LoZioo/Nucleo-Recorder/README.md

# Nucleo-Recorder
Legacy Nucleo-Recorder project repository.

[Brief documentation](docs/step%202.pdf)

## Final result
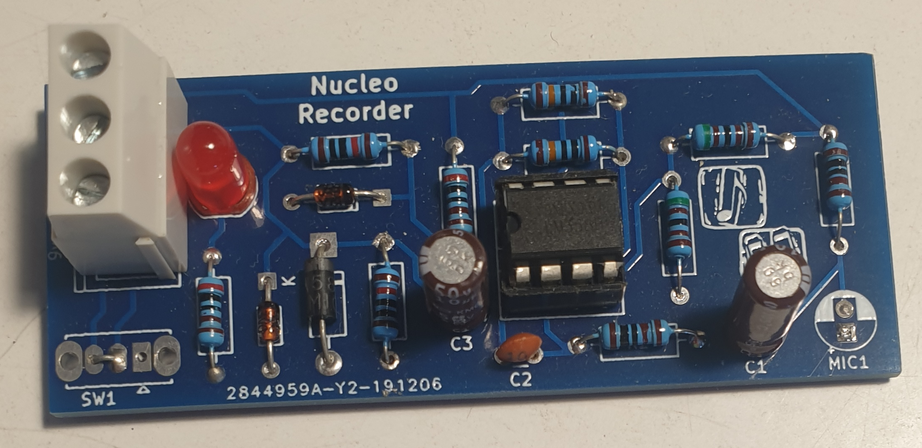
[picture p1: schematics/Device.png]
Device
