LoZioo/Nucleo-Recorder/docs/step 2/ADC_IRQ.JPG

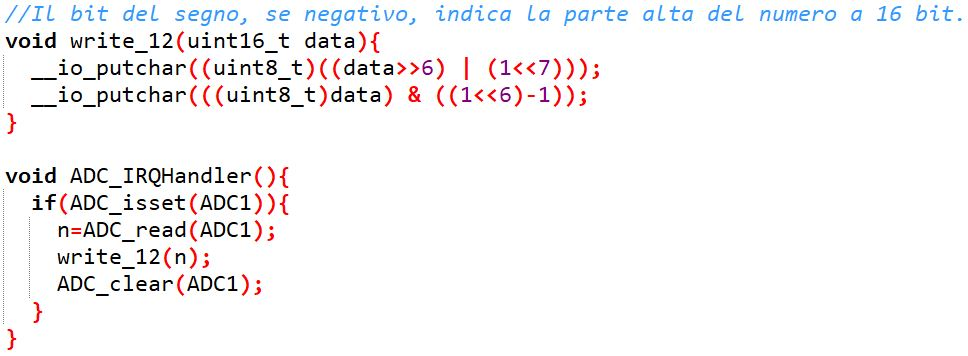
docs/step 2/ADC_IRQ.JPG
