LoZioo/Nucleo-Recorder/docs/step 2/Circuito.JPG

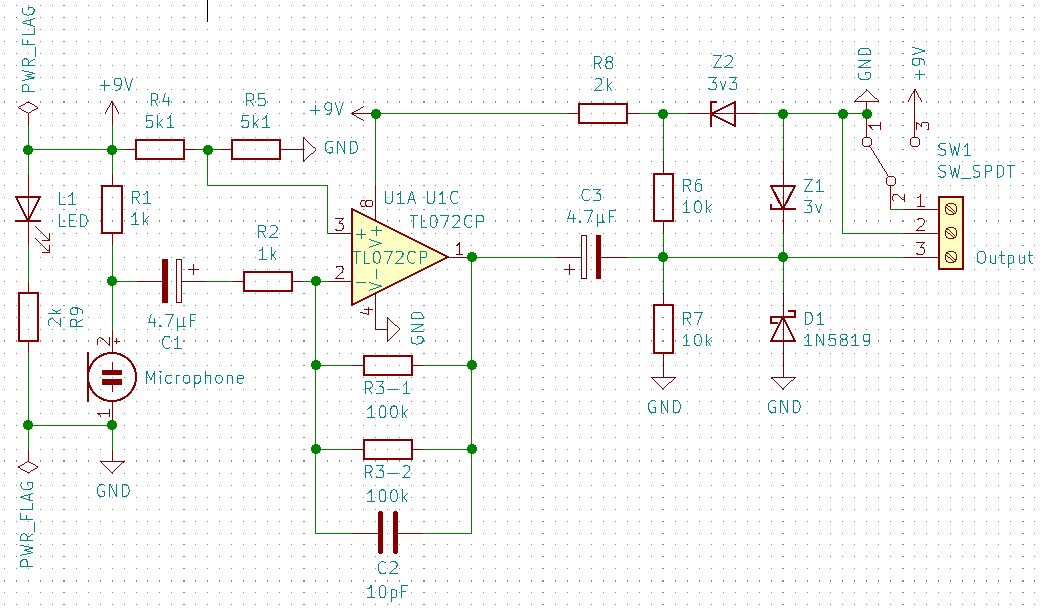
docs/step 2/Circuito.JPG
