LoZioo/Nucleo-Recorder/docs/step 2/Timer.JPG

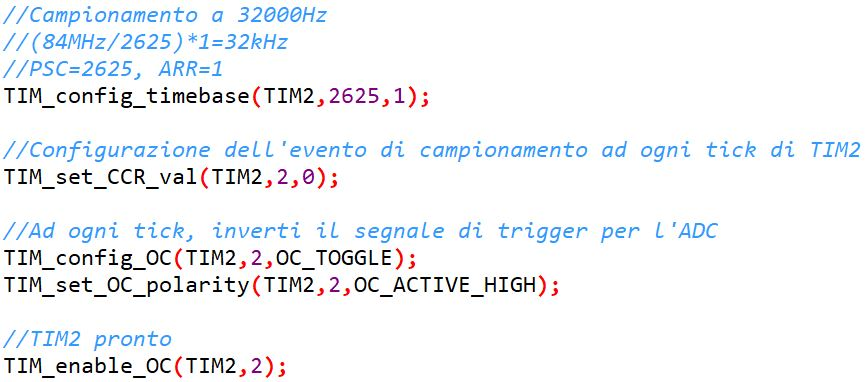
docs/step 2/Timer.JPG
