LoZioo/Nucleo-Recorder/docs/step 3/bit.jpg

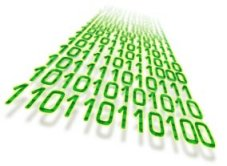
docs/step 3/bit.jpg
