LoZioo/Nucleo-Recorder/docs/step 3/electret-microphone.jpg

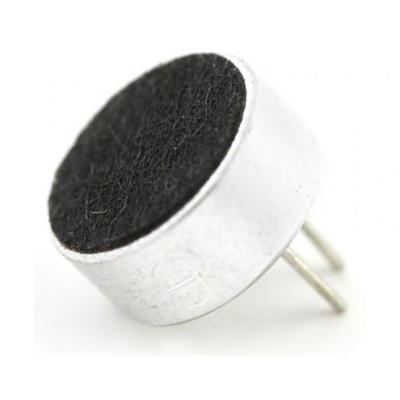
docs/step 3/electret-microphone.jpg
