LoZioo/Nucleo-Recorder/docs/step 3/FM Transmitter.JPG

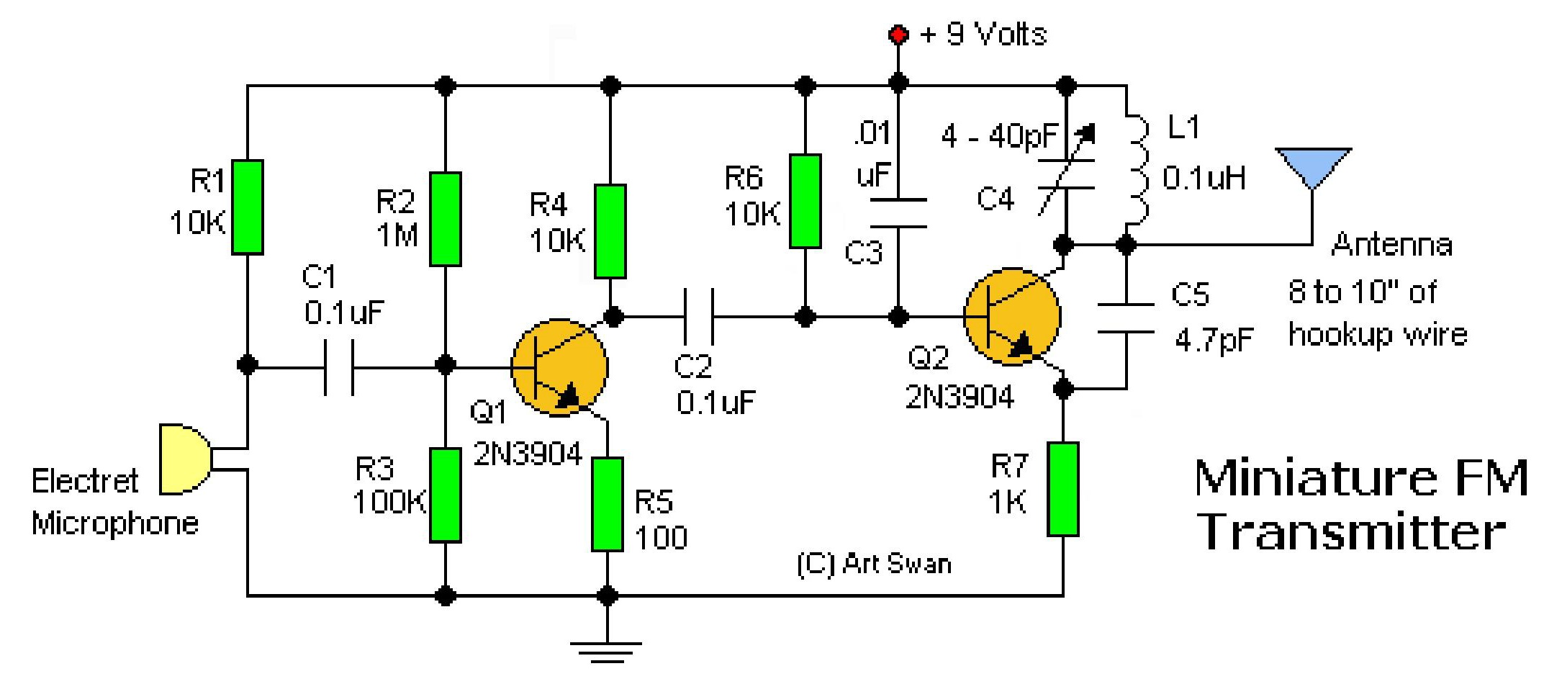
docs/step 3/FM Transmitter.JPG
