LoZioo/Nucleo-Recorder/docs/step 3/FM-Transmitter-Circuit.jpg

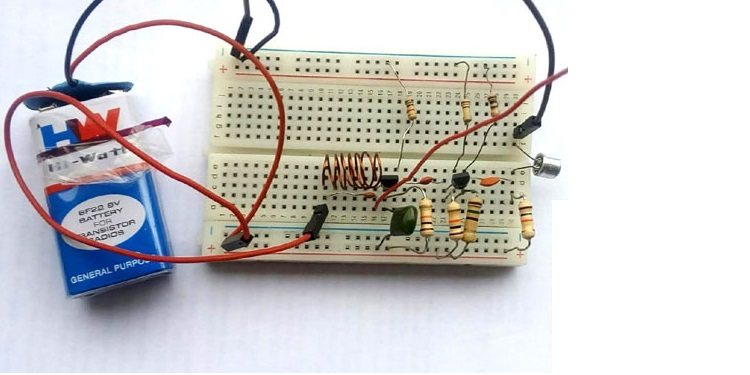
docs/step 3/FM-Transmitter-Circuit.jpg
