LoZioo/Nucleo-Recorder/docs/step 3/idea.jpg

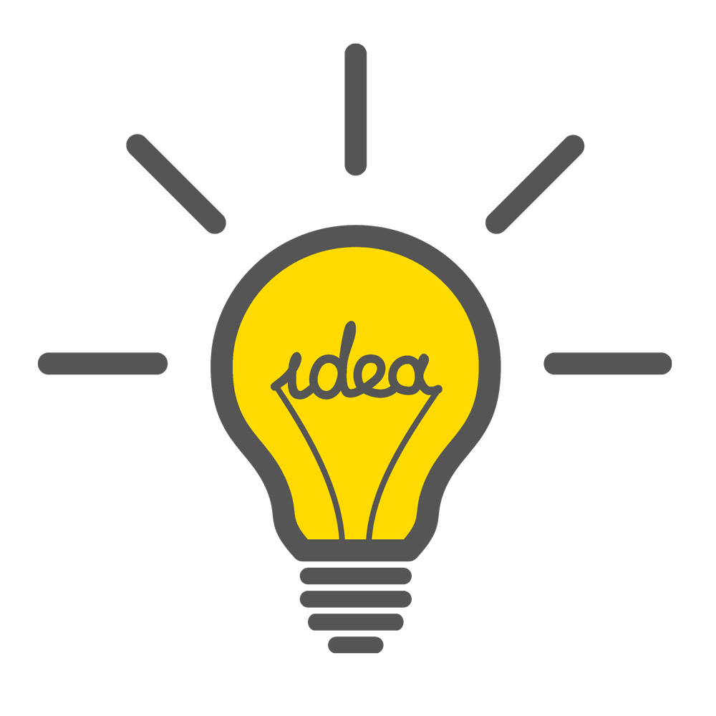
docs/step 3/idea.jpg
