LoZioo/Nucleo-Recorder/docs/step 3/not bad.jpg

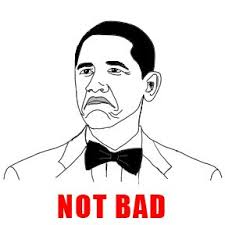
docs/step 3/not bad.jpg
