LoZioo/Nucleo-Recorder/docs/step 3/PCB.JPG

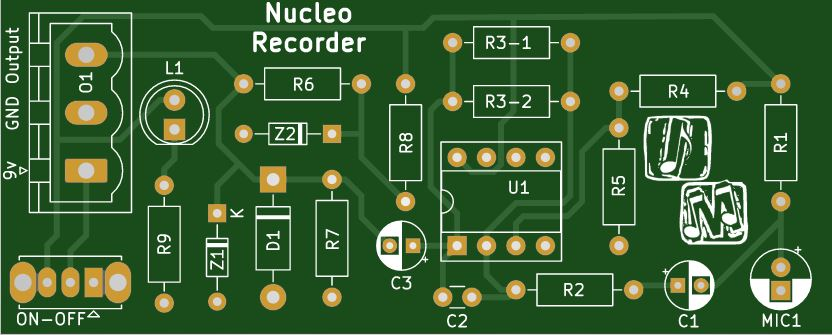
docs/step 3/PCB.JPG
