LoZioo/Nucleo-Recorder/docs/step 3/stm32-nucleo-f401re.jpg

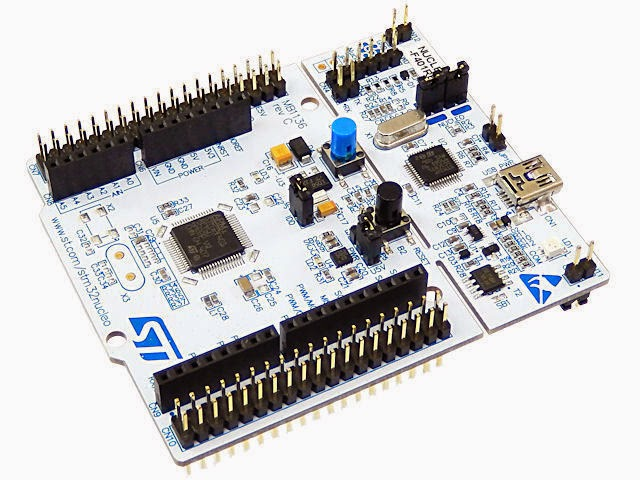
docs/step 3/stm32-nucleo-f401re.jpg
