LoZioo/Nucleo-Recorder/schematics/Microfono/Microfono.kicad_pcb

## KiCad design schematics/Microfono/Microfono.kicad_pcb (2023-10-05)

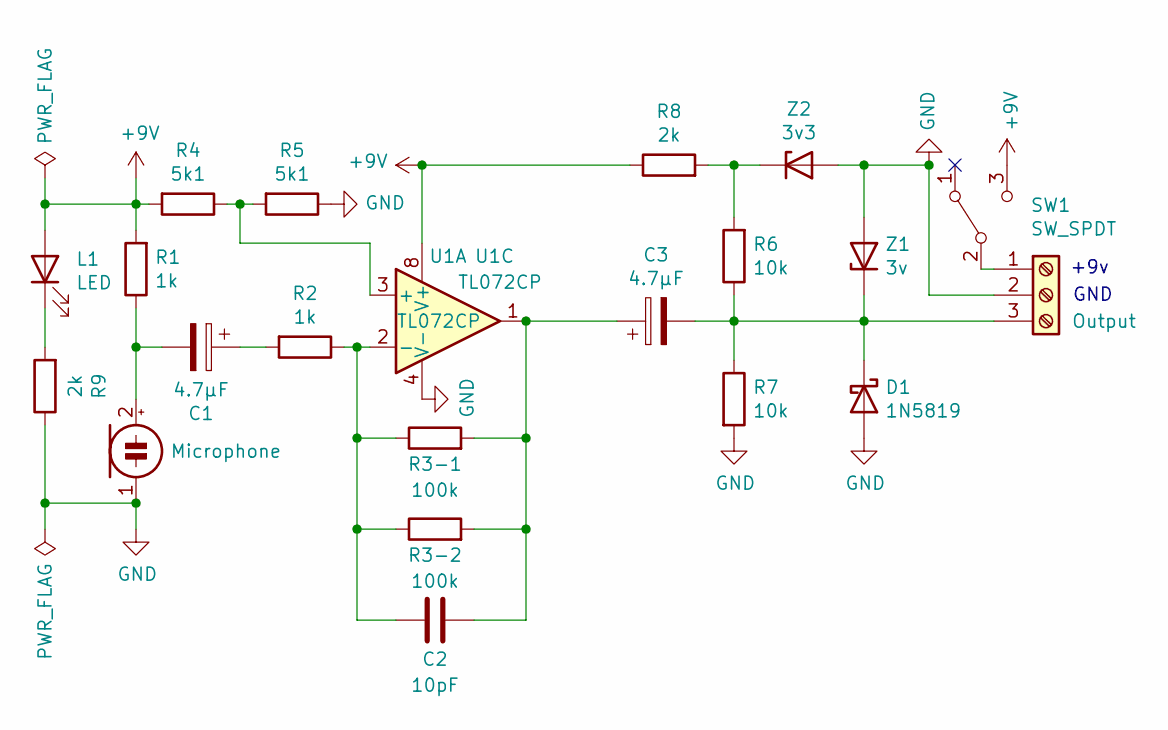
[picture p28: schematic Microfono.kicad_sch]

Parts:
C1, C3: 4.7µF; CP_Radial_D4.0mm_P2.00mm
C2: 10pF; C_Disc_D3.0mm_W1.6mm_P2.50mm
D1: 1N5819; D_DO-41_SOD81_P10.16mm_Horizontal
L1: LED; LED_D5.0mm
MIC1: Microphone; CP_Radial_D5.0mm_P2.00mm
O1: Output; PhoenixContact_MSTBVA_2,5_3-G_1x03_P5.00mm_Vertical
R1, R2: 1k; R_Axial_DIN0207_L6.3mm_D2.5mm_P10.16mm_Horizontal
R3-1, R3-2: 100k; R_Axial_DIN0207_L6.3mm_D2.5mm_P10.16mm_Horizontal
R4, R5: 5k1; R_Axial_DIN0207_L6.3mm_D2.5mm_P10.16mm_Horizontal
R6, R7: 10k; R_Axial_DIN0207_L6.3mm_D2.5mm_P10.16mm_Horizontal
R8, R9: 2k; R_Axial_DIN0207_L6.3mm_D2.5mm_P10.16mm_Horizontal
SW1: SW_SPDT; SW_Slide_1P2T_CK_OS102011MS2Q
U1: TL072CP; DIP-8_W7.62mm_Socket
Z1: 3v; D_DO-34_SOD68_P7.62mm_Horizontal
Z2: 3v3; D_DO-34_SOD68_P7.62mm_Horizontal

Connections:
+9V: L1.2 (A), R1.2, R4.2, R8.1, SW1.3 (C), U1.8 (V+); also elsewhere on the board
GND: D1.2 (A), MIC1.1 (-), O1.2, R5.1, R7.2, R9.1, U1.4 (V-), Z1.2 (A), Z2.2 (A)
unnamed: C1.1, R2.2
unnamed: C1.2, MIC1.2 (+), R1.1
unnamed: C2.1, R2.1, R3-1.1, R3-2.1, U1.2 (-)
unnamed: C2.2, C3.1, R3-1.2, R3-2.2, U1.1
unnamed: C3.2, D1.1 (K), O1.3, R6.1, R7.1, Z1.1 (K)
unnamed: L1.1 (K), R9.2
unnamed 8: O1.1, SW1.2 (B); also elsewhere on the board
unnamed: R4.1, R5.2, U1.3 (+)
unnamed: R6.2, R8.2, Z2.1 (K)

Notes on the sheet:
+9v
GND

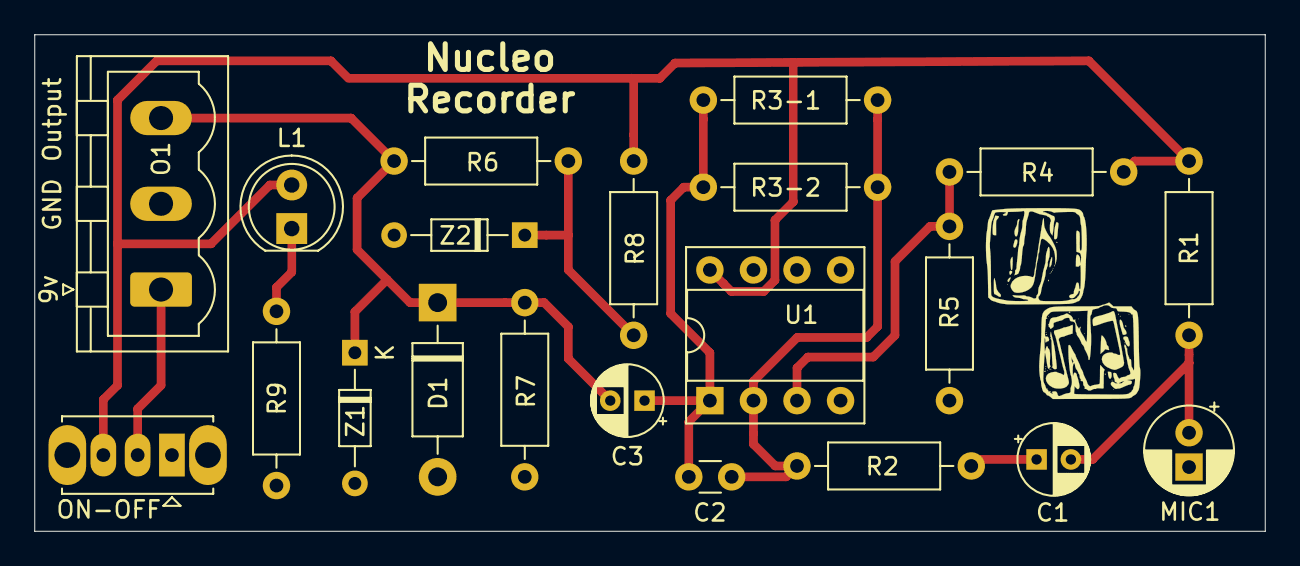
[picture p29: board Microfono.kicad_pcb from above]

Board: 2 copper layers, 71.8 x 29.0 mm, 21 parts (0 on the bottom side), 11 nets.

Other parts of the board:
ON-OFF: SW_SPDT; SW_Slide_1P2T_CK_OS102011MS2Q

Their connections:
+9V: ON-OFF.3; also elsewhere on the board
unnamed 8: ON-OFF.2; also elsewhere on the board
