LoZioo/Nucleo-Recorder/src/stm32/stm32_unict_lib/inc/stm32_unict_lib.h

/*
 * unict_lib.h
 */

#include "gpio.h"
#include "systick.h"
#include "timers.h"
#include "usart.h"
#include "console.h"
#include "display.h"
#include "adc.h"
#include "i2c.h"

//Nuove librerie
#include "utils.h"
//--------------
